coloradocube/balloonsat-bus/README.md

# ballonsat-bus
EPS, C&DH + COMMS or C3, CAN-FD for a balloonsat.

## Rework for v0.2

A list of [modification requirements](modifications.md).
