coloradocube/balloonsat-bus/EPS/Project Schedule_RevA.JPG

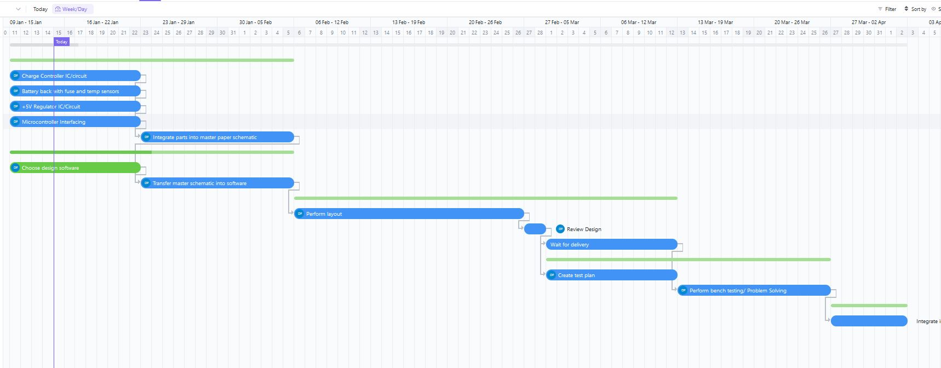
EPS/Project Schedule_RevA.JPG
