coloradocube/balloonsat-bus/Payload/Payload_level1.PNG

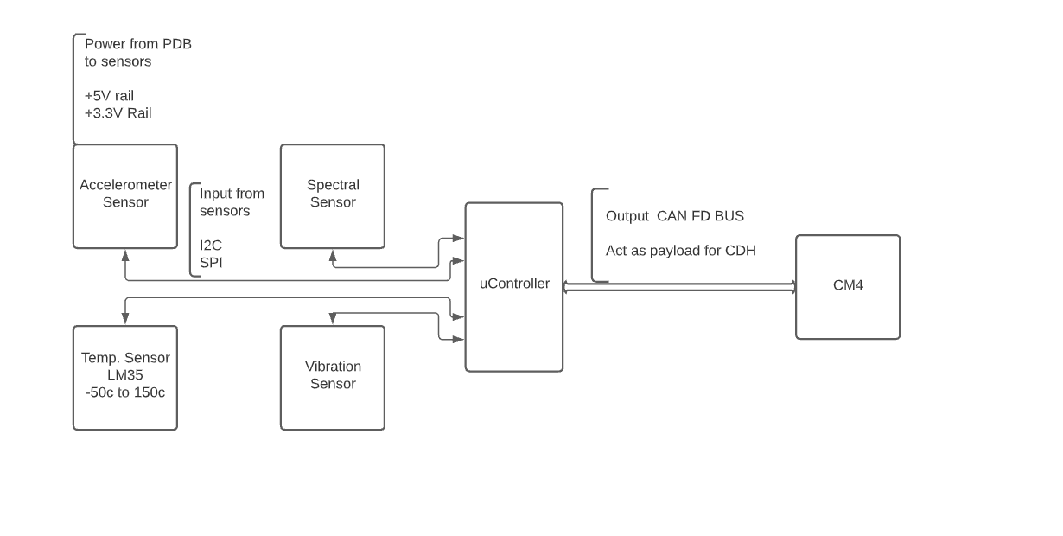
Payload/Payload_level1.PNG
