coloradocube/balloonsat-bus/Links.xlsx

For: | Description: | Link:
Power Board | Charge/Overcharge IC | https://www.addicore.com/TP4056-Charger-and-Protection-Module-p/ad310.htm
