coloradocube/balloonsat-bus/EPS/Misc Reference Docs/Budgets2.xls

Sheet: Main
Power Calculations for the RABBIT
Solar Constant | 1367 | W/m2 |  | Orbit | 800 | km
Efficiency | 15.0% |  |  | Period | 100.87 | min
Regulator Loss | 20.0% |  |  | Eclipse | 35.13 | min
switching Loss | 5.0% |  |  | Rev/day | 14.24
wiring Loss | 2.0% |  |  | REarth | 6378.14 | km
inherent degredation | 77.0%
packing factor | 80.0%
CubeSat length | 2.0
Area 1 | 0.002 | m2 | Minimum Area: 1/2 face open to environment
Area 2 | 0.016 | m2 | Side area for 1+ cube size
Area 3 | 0.008 | m2 | CubeSat side 8x10cm populated with cells
 |  |  | Power Avalable Whrs
Average Power Densities |  |  | per Orbit | per Day
Nominal | 1.06 | W | 1.16 | 16.50
Extended | 1.76 | W | 1.93 | 27.47

Sheet: Sun Angle
Sun Angle Approximation
Angle | Cosine | Adjusted
0 | 100.00% | 100.00%
5 | 99.62% | 99.62%
10 | 98.48% | 98.48%
15 | 96.59% | 96.58%
20 | 93.97% | 93.92%
25 | 90.63% | 90.46%
30 | 86.60% | 86.13%
35 | 81.92% | 80.85%
40 | 76.60% | 74.49%
45 | 70.71% | 66.96%
50 | 64.28% | 58.22%
55 | 57.36% | 48.29%
60 | 50.00% | 37.34%
65 | 42.26% | 25.64%
70 | 34.20% | 13.55%
75 | 25.88% | 1.52%
80 | 17.36% | 0.00%
85 | 8.72% | 0.00%
90 | 6.125742275e-15% | 0.00%

Sheet: Power Calcs
 | Percent Area visible in spin or tumble with respect to the sun |  |  |  |  |  | Power Provided during Spin or Tumble
 | Rotation about X |  |  | Rotation about X&Y |  |  | Nominal Cube |  | 1+ Cube
Angle | Area 1 | Area 2 | Area 3 | Area 1 | Area 2 | Area 3 | spin | tumble | spin | tumble
0 | 1.00 | 0.00 | 0.00 | 1.00 | 0.00 | 0.00 | 0.244 | 0.244 | 0.244 | 0.244
5 | 1.00 | 0.00 | 0.00 | 1.00 | 0.00 | 0.00 | 0.243 | 0.243 | 0.243 | 0.243
10 | 0.98 | 0.00 | 0.00 | 0.98 | 0.00 | 0.00 | 0.241 | 0.241 | 0.241 | 0.241
15 | 0.97 | 0.02 | 0.00 | 0.97 | 0.03 | 0.00 | 0.251 | 0.266 | 0.266 | 0.295
20 | 0.94 | 0.14 | 0.00 | 0.94 | 0.27 | 0.00 | 0.362 | 0.494 | 0.494 | 0.759
25 | 0.90 | 0.26 | 0.00 | 0.90 | 0.51 | 0.00 | 0.472 | 0.722 | 0.722 | 1.223
30 | 0.86 | 0.37 | 0.00 | 0.86 | 0.75 | 0.00 | 0.575 | 0.940 | 0.940 | 1.670
35 | 0.81 | 0.48 | 0.00 | 0.81 | 0.97 | 0.00 | 0.670 | 1.142 | 1.142 | 2.086
40 | 0.74 | 0.58 | 0.00 | 0.74 | 1.16 | 0.00 | 0.751 | 1.320 | 1.320 | 2.458
45 | 0.67 | 0.67 | 0.00 | 0.67 | 1.34 | 0.00 | 0.818 | 1.473 | 1.473 | 2.782
50 | 0.58 | 0.74 | 0.00 | 0.58 | 1.34 | 0.00 | 0.870 | 1.451 | 1.598 | 2.760
55 | 0.48 | 0.81 | 0.00 | 0.48 | 1.34 | 0.00 | 0.908 | 1.427 | 1.698 | 2.736
60 | 0.37 | 0.86 | 0.00 | 0.37 | 1.34 | 0.00 | 0.933 | 1.400 | 1.775 | 2.709
65 | 0.26 | 0.90 | 0.00 | 0.26 | 1.34 | 0.00 | 0.947 | 1.372 | 1.831 | 2.681
70 | 0.14 | 0.94 | 0.00 | 0.14 | 1.34 | 0.00 | 0.951 | 1.342 | 1.869 | 2.651
75 | 0.02 | 0.97 | 0.00 | 0.02 | 1.34 | 0.00 | 0.948 | 1.313 | 1.892 | 2.622
80 | 0.00 | 0.98 | 0.00 | 0.00 | 1.34 | 0.00 | 0.963 | 1.309 | 1.925 | 2.618
85 | 0.00 | 1.00 | 0.00 | 0.00 | 1.34 | 0.00 | 0.974 | 1.309 | 1.947 | 2.618
90 | 0.00 | 1.00 | 0.00 | 0.00 | 1.34 | 0.00 | 0.977 | 1.309 | 1.955 | 2.618
95 | 0.00 | 1.00 | 0.00 | 0.00 | 1.34 | 0.00 | 0.974 | 1.309 | 1.947 | 2.618
100 | 0.00 | 0.98 | 0.00 | 0.00 | 1.34 | 0.00 | 0.963 | 1.309 | 1.925 | 2.618
105 | 0.00 | 0.97 | 0.02 | 0.00 | 1.34 | 0.02 | 0.959 | 1.324 | 1.903 | 2.633
110 | 0.00 | 0.94 | 0.14 | 0.00 | 1.34 | 0.14 | 1.050 | 1.441 | 1.968 | 2.750
115 | 0.00 | 0.90 | 0.26 | 0.00 | 1.34 | 0.26 | 1.135 | 1.560 | 2.019 | 2.869
120 | 0.00 | 0.86 | 0.37 | 0.00 | 1.34 | 0.37 | 1.207 | 1.674 | 2.049 | 2.983
125 | 0.00 | 0.81 | 0.48 | 0.00 | 1.34 | 0.48 | 1.262 | 1.781 | 2.052 | 3.090
130 | 0.00 | 0.74 | 0.58 | 0.00 | 1.34 | 0.58 | 1.297 | 1.878 | 2.025 | 3.187
135 | 0.00 | 0.67 | 0.67 | 0.00 | 1.34 | 0.67 | 1.309 | 1.963 | 1.963 | 3.272
140 | 0.00 | 0.58 | 0.74 | 0.00 | 1.16 | 0.74 | 1.297 | 1.866 | 1.866 | 3.004
145 | 0.00 | 0.48 | 0.81 | 0.00 | 0.97 | 0.81 | 1.262 | 1.734 | 1.734 | 2.678
150 | 0.00 | 0.37 | 0.86 | 0.00 | 0.75 | 0.86 | 1.207 | 1.572 | 1.572 | 2.302
155 | 0.00 | 0.26 | 0.90 | 0.00 | 0.51 | 0.90 | 1.135 | 1.385 | 1.385 | 1.886
160 | 0.00 | 0.14 | 0.94 | 0.00 | 0.27 | 0.94 | 1.050 | 1.183 | 1.183 | 1.448
165 | 0.00 | 0.02 | 0.97 | 0.00 | 0.03 | 0.97 | 0.959 | 0.974 | 0.974 | 1.003
170 | 0.00 | 0.00 | 0.98 | 0.00 | 0.00 | 0.98 | 0.963 | 0.963 | 0.963 | 0.963
175 | 0.00 | 0.00 | 1.00 | 0.00 | 0.00 | 1.00 | 0.974 | 0.974 | 0.974 | 0.974
180 | 0.00 | 0.00 | 1.00 | 0.00 | 0.00 | 1.00 | 0.977 | 0.977 | 0.977 | 0.977
Average | 0.29 | 0.55 | 0.29 | 0.29 | 0.89 | 0.29 | 0.89 | 1.22 | 1.43 | 2.09

Sheet: Up-Link Margin
 | Up-Link Budget
 |  |  | El Angle | 0 | 10 | 35 | 65 | 90
Item | Symbol | Units | Source | DL | DL | DL | DL | DL
Antenna Efficiency | h | % | Input parameter | 55 | 55 | 55 | 55 | 55 | micro hard on narcissisat
Frequency | f | GHz | Input parameter | 2 | 2 | 2 | 2 | 2
Transmitter Power | P | Watts | Input parameter | 1 | 1 | 1 | 1 | 1
Transmitter Power | P | dBW | 10log(P) | 0 | 0 | 0 | 0 | 0
Transmitter Line Loss | Ll | dBW | Input parameter | -1 | -1 | -1 | -1 | -1
Transmit Antenna Beamwidth | qt | deg | Input parameter | 2 | 2 | 2 | 2 | 2
Peak Transmit Antenna Gain | Gpt | dB | Eq. (13-20) | 38.3 | 38.3 | 38.3 | 38.3 | 38.3
Transmit Antenna Diameter | Dt | m | Eq. (13-19) | 5.2 | 5.2 | 5.2 | 5.2 | 5.2
Transmit Antenna Pointing Offset | et | deg | Input parameter | 0.2 | 0.2 | 0.2 | 0.2 | 0.2
Transmit Antenna Pointing Loss | Lpt | dB | Eq. (13.21) | -0.12 | -0.12 | -0.12 | -0.12 | -0.12
Transmit Antenna Gain (net) | Gt | dB | Gpt+Lpt | 38.2 | 38.2 | 38.2 | 38.2 | 38.2
Eq. Isotropica Radiated Power | EIRP | dBW | P+Ll+Gt | 37.16 | 37.16 | 37.16 | 37.16 | 37.16
Propagation Path Length | S | km | from Main | 3293.18 | 2366.88 | 1263.90 | 872.25 | 800.00
Space Loss | Ls | dB | Eq (13-23a) | -168.8 | -166.0 | -160.5 | -157.3 | -156.5
Propagation and Polarization Loss | La | dB | Fig. 13-10 | -0.3 | -0.3 | -0.3 | -0.3 | -0.3
Recieve Antenna Diameter | Dr | m | Input parameter | 0.07 | 0.07 | 0.07 | 0.07 | 0.07
Peak Receive Antenna Gain (net) | Grp | dBi | Eq (13-18a) | 0.74 | 0.74 | 0.74 | 0.74 | 0.74
Recieve Antenna Beamwidth | qr | deg | Eq (13-19) | 150.0 | 150.0 | 150.0 | 150.0 | 150.0
Recieve Antenna Pointing Error | er | deg | Input parameter | 70 | 70 | 70 | 70 | 70
Receive Antenna Pointing Loss | Lpr | dB | Eq (13-21) | -2.6 | -2.6 | -2.6 | -2.6 | -2.6
Receive Antenna Gain | Gr | dB | Grp+Lpr | -1.9 | -1.9 | -1.9 | -1.9 | -1.9
System Noise Temperature | Ts | K | Table 13-10 | 614 | 614 | 614 | 614 | 614
Data Rate | R | bps | Input parameter | 100 | 100 | 100 | 100 | 100
Eb/No (1) | Eb/No | dB | Eq (13-13) | 44.4 | 47.3 | 52.7 | 55.9 | 56.7
Carrier-to-Noise Density Ratio | C/No | dB-Hz | Eq (13-15a) | 64.4 | 67.3 | 72.7 | 75.9 | 76.7
Bit Error Rate | BER |  | Input parameter | 1e-07 | 1e-07 | 1e-07 | 1e-07 | 1e-07
Required Eb/No (2) | Req Eb/No | dB-Hz | Fig. 13-9 | 11.3 | 11.3 | 11.3 | 11.3 | 11.3
Implimentation Loss (3) |  | dB | Estimated | -2 | -2 | -2 | -2 | -2
Margin |  | dB | (1)-(2)+(3) | 31.1 | 34.0 | 39.4 | 42.6 | 43.4

Sheet: Down-Link Margin
 | Down-Link Budget
 |  |  | El Angle | 0 | 10 | 35 | 65 | 90
Item | Symbol | Units | Source | DL | DL | DL | DL | DL
Antenna Efficiency | h | % | Input parameter | 25 | 25 | 25 | 25 | 25
Frequency | f | GHz | Input parameter | 2.4 | 2.4 | 2.4 | 2.4 | 2.4
Transmitter Power | P | Watts | Input parameter | 1 | 1 | 1 | 1 | 1
Transmitter Power | P | dBW | 10log(P) | 0 | 0 | 0 | 0 | 0
Transmitter Line Loss | Ll | dBW | Input parameter | -0.25 | -0.25 | -0.25 | -0.25 | -0.25
Transmit Antenna Beamwidth | qt | deg | Input parameter | 70 | 70 | 70 | 70 | 70
Peak Transmit Antenna Gain | Gpt | dB | Eq. (13-20) | 0.0 | 0.0 | 0.0 | 0.0 | 0.0
Transmit Antenna Diameter | Dt | m | Eq. (13-19) | 0.1 | 0.1 | 0.1 | 0.1 | 0.1
Transmit Antenna Pointing Offset | et | deg | Input parameter | 27 | 27 | 27 | 27 | 27
Transmit Antenna Pointing Loss | Lpt | dB | Eq. (13.21) | 0.0 | 0.0 | 0.0 | 0.0 | 0.0
Transmit Antenna Gain (net) | Gt | dB | Gpt+Lpt | 0.0 | 0.0 | 0.0 | 0.0 | 0.0
Eq. Isotropica Radiated Power | EIRP | dBW | P+Ll+Gt | -0.25 | -0.25 | -0.25 | -0.25 | -0.25
Propagation Path Length | S | km | from Main | 3293.18 | 2366.88 | 1263.90 | 872.25 | 800.00
Space Loss | Ls | dB | Eq (13-23a) | -170.4 | -167.5 | -162.1 | -158.9 | -158.1
Propagation and Polarization Loss | La | dB | Fig. 13-10 | -0.3 | -0.3 | -0.3 | -0.3 | -0.3
Recieve Antenna Diameter | Dr | m | Input parameter | 20.0 | 20 | 20 | 20 | 20
Peak Receive Antenna Gain (net) | Grp | dBi | Eq (13-18a) | 48.01 | 48.01 | 48.01 | 48.01 | 48.01
Recieve Antenna Beamwidth | qr | deg | Eq (13-19) | 0.4 | 0.4 | 0.4 | 0.4 | 0.4
Recieve Antenna Pointing Error | er | deg | Input parameter | 0.2 | 0.2 | 0.2 | 0.2 | 0.2
Receive Antenna Pointing Loss | Lpr | dB | Eq (13-21) | -2.5 | -2.5 | -2.5 | -2.5 | -2.5
Receive Antenna Gain | Gr | dB | Grp+Lpr | 45.5 | 45.5 | 45.5 | 45.5 | 45.5
System Noise Temperature | Ts | K | Table 13-10 | 135 | 135 | 135 | 135 | 135
Data Rate | R | bps | Input parameter | 1200 | 1200 | 1200 | 1200 | 110000
Eb/No (1) | Eb/No | dB | Eq (13-13) | 48.5 | 51.4 | 56.9 | 60.1 | 41.2
Carrier-to-Noise Density Ratio | C/No | dB-Hz | Eq (13-15a) | 79.3 | 82.2 | 87.7 | 90.9 | 91.6
Bit Error Rate | BER |  | Input parameter | 1e-06 | 1e-06 | 1e-06 | 1e-06 | 1e-06
Required Eb/No (2) | Req Eb/No | dB-Hz | Fig. 13-9 | 14 | 14 | 14 | 14 | 14
Implimentation Loss (3) |  | dB | Estimated | -2 | -2 | -2 | -2 | -2
Margin |  | dB | (1)-(2)+(3) | 32.5 | 35.4 | 40.9 | 44.1 | 25.2

Sheet: Comm Budget
Reading | 8 | bit |  |  |  | reading | 8 | bit
Time | 1 | per min |  |  |  | Time | 1 | per hour
Temp Sensors |  | Voltages |  | Current |  | MRC |  | FFPG
panels | 6 | bus | 1 | panels | 6 | data | 1000 | data | 1000
battery | 1 | battery | 1 | battery | 1
structure | 5 | convertors | 3 | bus | 1
cpu | 1 |  |  | convertors | 3
TX | 2 |  |  | cpu | 1
EPS | 3 |  |  | TX | 1
 |  |  |  | payload | 8
bps | 2.4 |  | 0.6666666667 |  | 2.8 |  | 2.222222222 |  | 2.222222222
Total | 10.31111111 | bps
 | 890880 | bp day
growth factor | 2
passes | 4 | 8 | 4 | 4 | 8 | 4
total time | 32 | min
rate | 928 | baud

Sheet: Power Budget
Always on |  | @ 5min/hr |  | Transmit
Payload 1 Standby | 0.25 | MRC | 2 | TX | 1
Payload 2 Standby | 0.5 | FFPG | 3
CPU | 0.5
RX | 0.25
AX.25 controller | 0.5
Totals | 2 |  | 5 |  | 1
WattHrs | 2 |  | 0.25 |  | 0.02222222222
Total WHr | 2.272222222
Per Day | 54.53333333
