coloradocube/balloonsat-bus/EPS/Battery Board/Battery Board/Battery Board.csv

Source: | C:\Users\alecj\Documents\GitHub\balloonsat-bus\EPS\Battery Board\Battery Board\Battery Board.kicad_sch
Date: | 3/24/2022 9:11:50 PM
Tool: | Eeschema (6.0.1)
Generator: | C:\Program Files\KiCad\6.0\bin\scripting\plugins/bom_csv_grouped_by_value_with_fp.py
Component Count: | 9
Ref | Qnty | Value | Cmp name | Footprint | Description | Vendor
F1, F2, F3, F4, | 4 | 65800001009 | 65800001009 | Fuse holder:65800001009
J1, | 1 | 436500212 | 436500212 | Connecter:436500212
U1, U2, U3, U4, | 4 | 1042 | 1042 | Battery holder:1042
