coloradocube/balloonsat-bus/Payload/ColoradoCUBE_Payloads/MS580502BA01-50/3D/MS580502BA01-50.stp

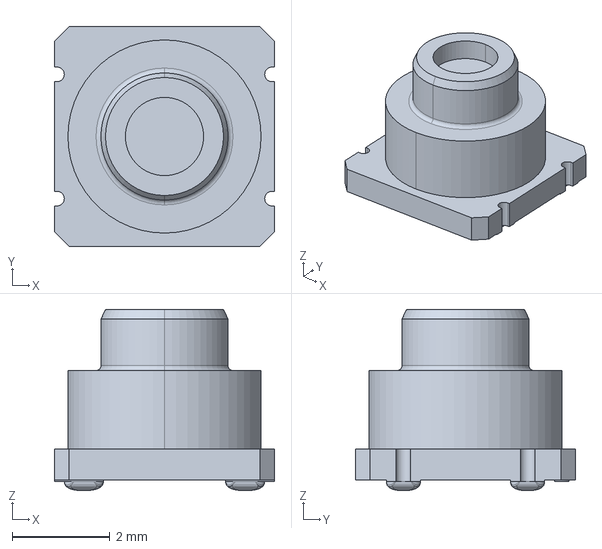
[picture p11: CAD file, 2022-04-02]
Payload/ColoradoCUBE_Payloads/MS580502BA01-50/3D/MS580502BA01-50.stp
4.50 x 4.50 x 3.71 mm
