coloradocube/balloonsat-bus/(list of files, cad)

Other CAD files:
Payload/ColoradoCUBE_Payloads/MS580502BA01-50/Allegro/ms580502ba0150.psm
Payload/ColoradoCUBE_Payloads/MS580502BA01-50/DEHDL/ms580502ba01_50/chips/chips.prt
