coloradocube/balloonsat-bus/(threads)

Thread 4 (2021-11-17):

C&DG board design

ivogeorg, 2021-11-17:

NotfatPrince, 2021-11-17:
# To Do
Study current [CM4 IO](https://datasheets.raspberrypi.com/cm4io/cm4io-datasheet.pdf) board and decide what we want to keep and what we need to add.

Thread 7 (2022-01-12):

EPS Paper schematic

dperry29, 2022-01-12:
Seth- Charge port & charge controller IC/circuit
Dan T- Battery back with fuse and temp sensors
Alec - DC/DC regulator IC/circuit
Dan P - Microcontroller interface with PDB and kria

Closed 2022-02-02.

Thread 8 (2022-01-12):

EPS PCB software schematic

dperry29, 2022-01-12:
Transition paper schematic into PCB software (Eagle or Kicad? TBD)

dperry29, 2022-02-02:
Working on integrating individual parts into master kicad sch
