coloradocube/balloonsat-bus/COMMS/Comms_TopLevel_v1.pdf

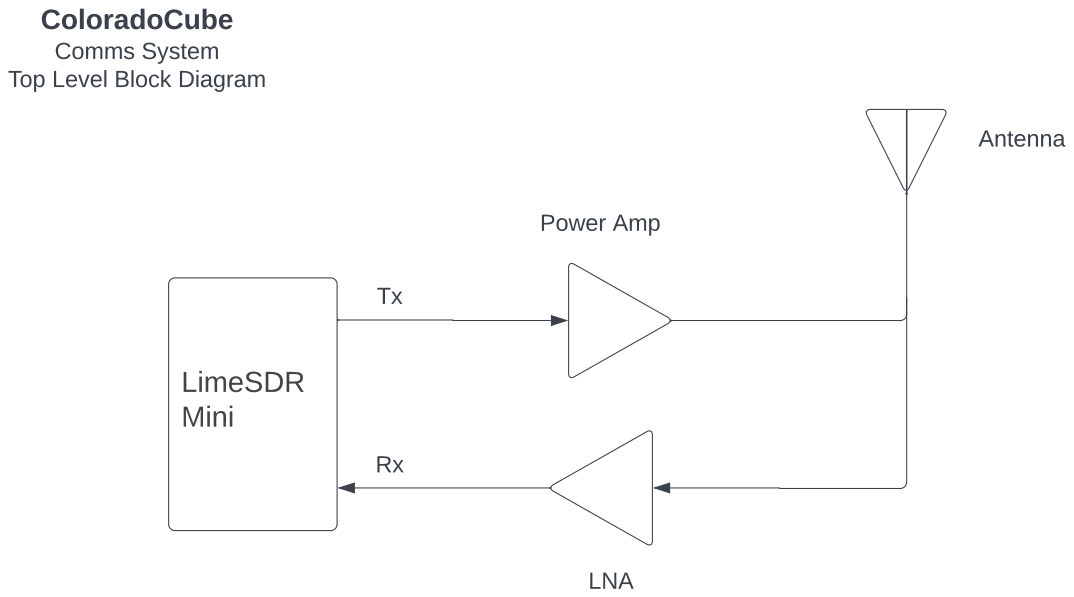
[picture p12: page 1]
LimeSDR Mini; Antenna; Power Amp; LNA

ColoradoCube
Comms System
Top Level Block Diagram
