coloradocube/balloonsat-bus/CD&H/C&DH.pdf

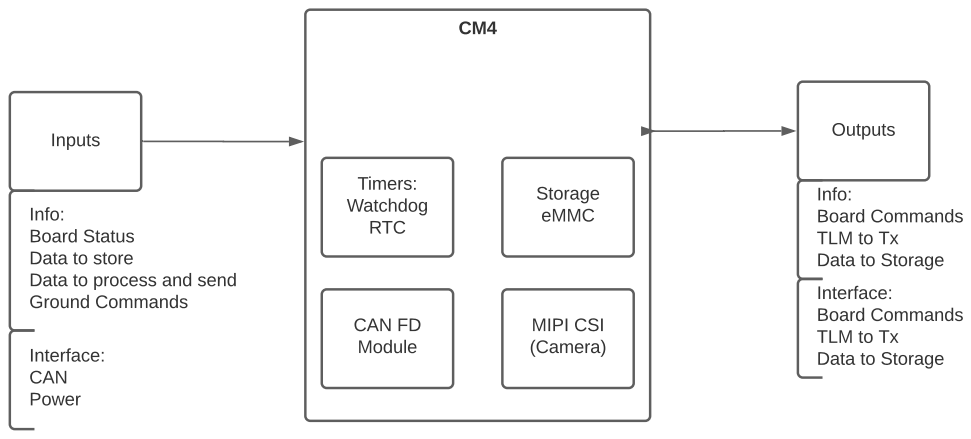
[picture p13: page 1]
s Info: Board Status Data to store Data to process and send Ground Commands Interface: CAN Power; Info: Board Co; ule; s: Watchdo g; MIPI C

Tim
SI (Camera) Storage eMMC

e Interface: Board Comman
