coloradocube/balloonsat-bus/CD&H/C&DH_level1.pdf

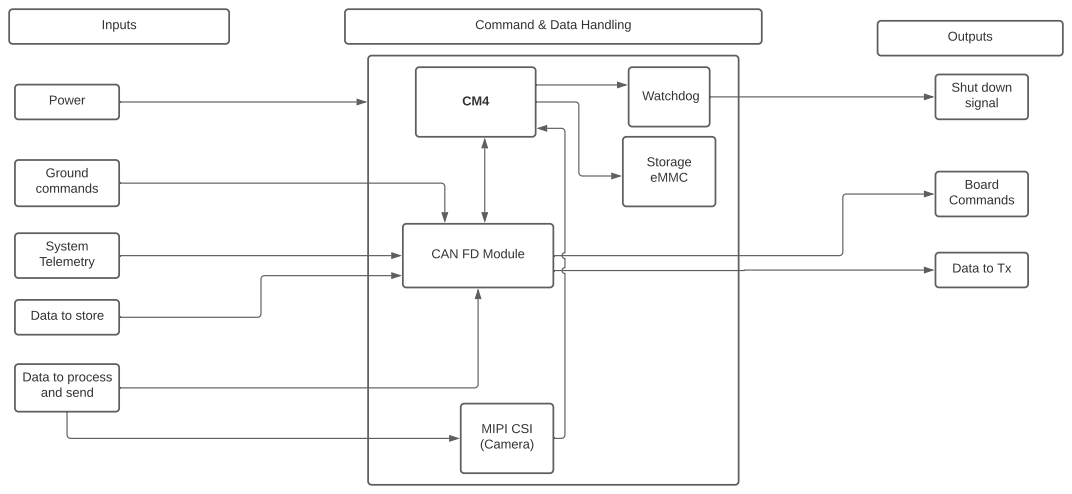
[picture p14: page 1]
ule; MIPI C; SI (Camera); dlin; Tele; sig
