coloradocube/balloonsat-bus/COMMS/COMMS_level1.pdf

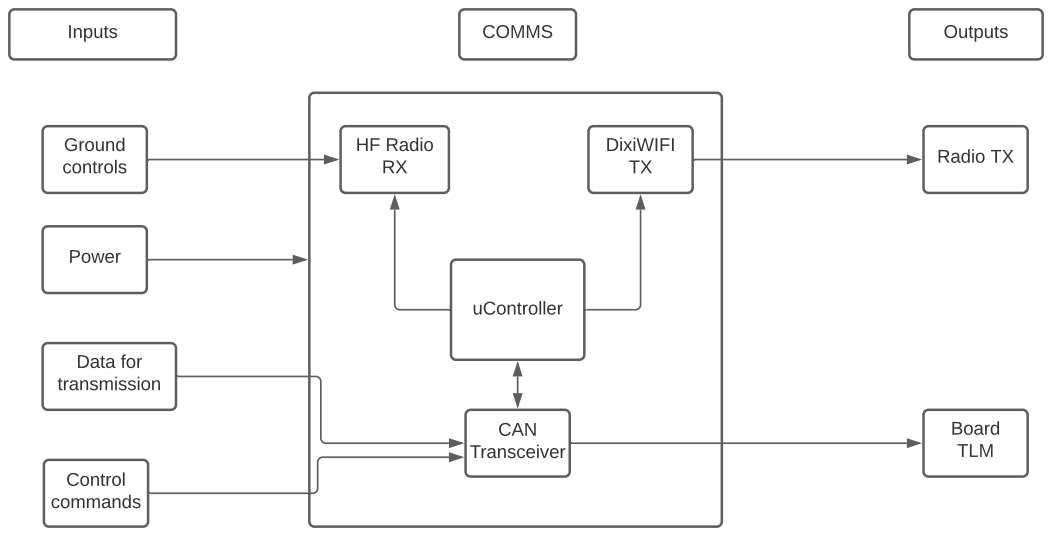
[picture p15: page 1]
Text; Inputs; COMMS; Outputs; HF Radio RX; uController; DixiWIFI TX; Data for transmission; Ground controls; Power; Control commands; Board TLM; Radio TX; CAN Transceiver
