coloradocube/balloonsat-bus/EPS/Block Diagrams/PDB_BlockDiagram_Rev-B.pdf

# ail +5V Rail +3.3V Rail XX Max C

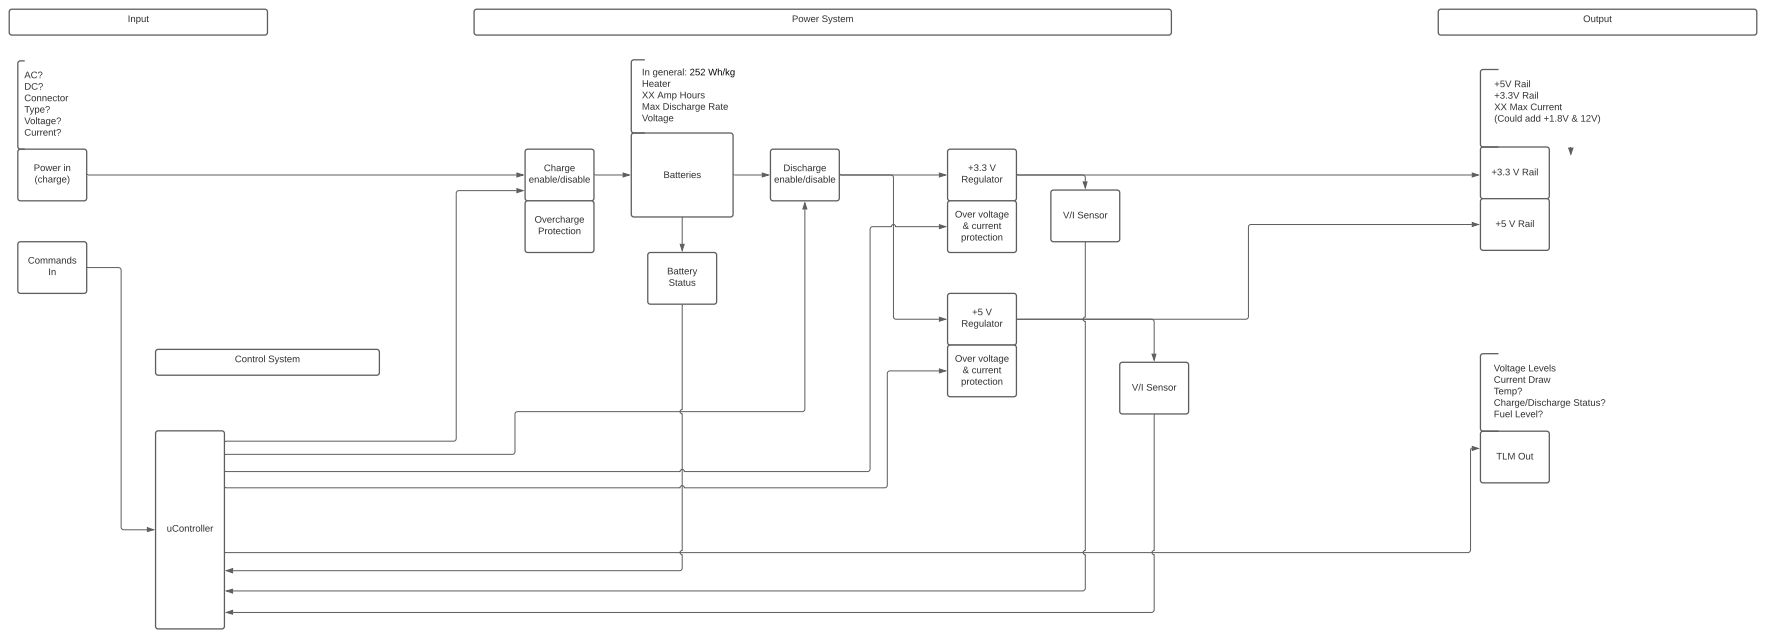
[picture p17: page 1]
s Input; Dis; ble; dis; uld; Volt; els; olle; rie; s In general: 252; ula; olt; tio; ail Charge
