coloradocube/balloonsat-bus/EPS/Block Diagrams/PDB_BlockDiagram_Rev-A.pdf

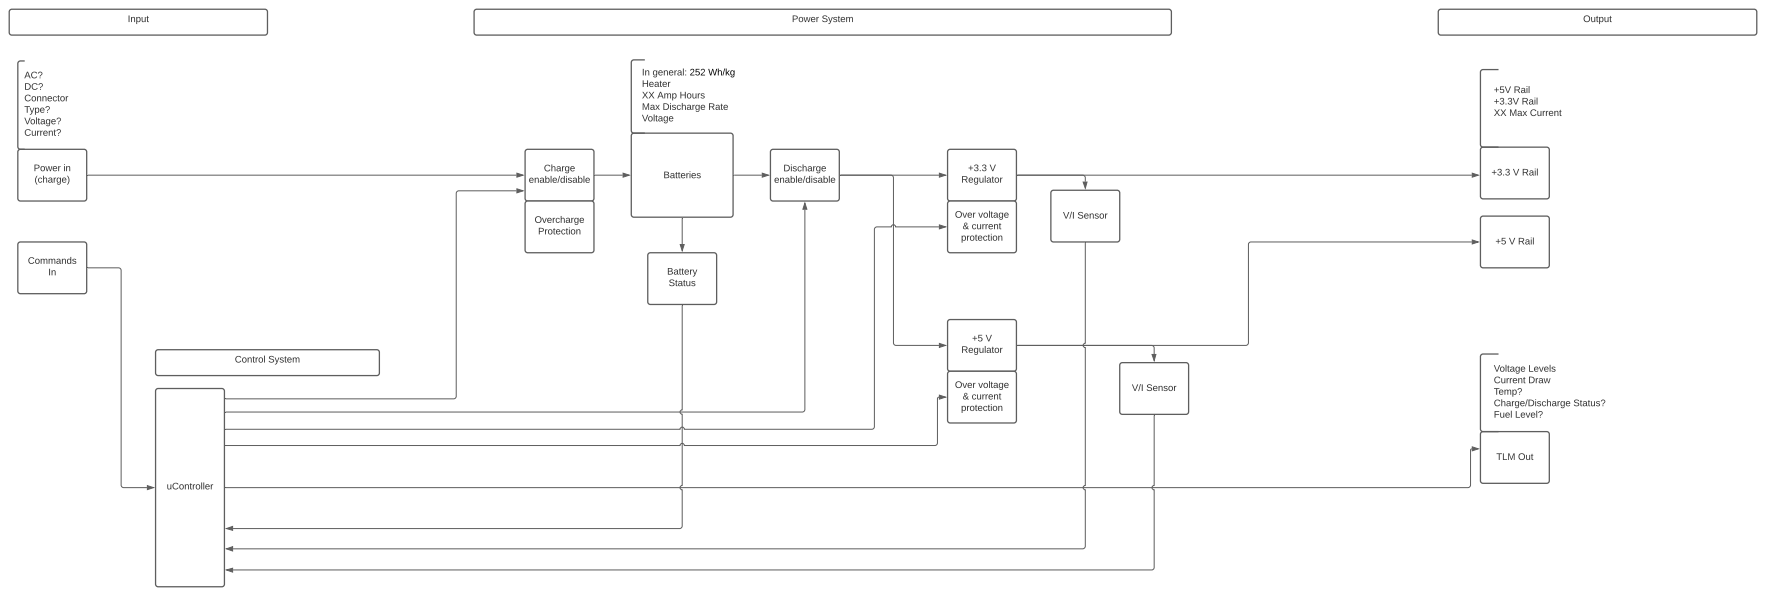
[picture p18: page 1]
s Input; Dis; ble; dis; Volt; els; olle; rie; s In general: 252; ula; olt; tio; ail Charge

ail +5V Rail +3.3V Rail XX Max Cu
