coloradocube/balloonsat-bus/(commit log)

2021-12-13 Reorganizing PDB
    Changed from PDB (power distro board) to EPS (electrical power subsytem. Added reference docs folder
2021-12-13 Added ref docs
    [Budgets2.xls, Power rev2.xls, Power.xls]
2022-01-15 Updated File Structure
    Updated File Structure
    [Budgets2.xls, EPS Master Schedule.xlsx, Power rev2.xls, Power.xls]
2022-01-24 Adding kicad folder
    [CDH.csv, CDH.kicad_pcb, CDH.kicad_sch, CM4IOv5.kicad_pcb, CM4IOv5.kicad_sch, CM4_GPIO.kicad_sch, CM4_HighSpeed.kicad_sch, PCIe.kicad_sch]
2022-01-26 added kicad libraries
2022-02-01 first upload
    [charge schem.kicad_pcb, charge schem.kicad_sch]
2022-02-01 added one piece - test
    [charge schem.kicad_sch]
2022-02-04 master schematic
    uploading the main schematic with all designs
    [charge schem.kicad_sch, converterschematic.kicad_sch, master_schematic.kicad_pcb, master_schematic.kicad_sch]
2022-02-11 Added MCU/CAN to master schematic
    [MCU_CAN.kicad_sch, master_schematic.kicad_sch]
2022-02-14 master schematic update
    added hierarchal pins to MCU_CAN, and attached it with the rest of the circuit
    [MCU_CAN.kicad_sch, master_schematic.kicad_sch]
2022-02-18 Updatig kiCAD files for C&DH
    [CDH.csv, CDH.kicad_pcb, CDH.kicad_sch, CM4IOv5.kicad_pcb, CM4IOv5.kicad_sch, CM4_GPIO.kicad_sch, CM4_HighSpeed.kicad_sch, PCIe.kicad_sch]
2022-02-19 added general CAD schematic for Danny
2022-02-25 updated master Schematic
    updated MCU
2022-02-25 actual master schematic update
    added mcu other files
    [CAN_Transceiver.kicad_sch, ColoradoCUBE_Payload.kicad_sch, DEBUG_INTERFACE.kicad_sch, Interboard_connector.kicad_sch, converterschematic.kicad_sch, eps_board.kicad_pcb, master_schematic.kicad_sch, pcb_template.kicad_pcb]
2022-02-25 revised EPS schematics
    [ColoradoCUBE_Payload.kicad_sch, Interboard_connector.kicad_sch, charge schem.kicad_sch, converterschematic.kicad_sch, master_schematic.kicad_sch, pcb_template.kicad_pcb]
2022-03-02 master schematic/pcb update
    updates schematic with OVP and added OVP to the PCB layout
    [Interboard_connector.kicad_sch, OVP.kicad_sch, eps_board.kicad_pcb, master_schematic.kicad_sch]
2022-03-02 updated master schematic
    should be nearing final schematic revision. run electrical rules check next
    [CAN_Transceiver.kicad_sch, ColoradoCUBE_Payload.kicad_sch, DEBUG_INTERFACE.kicad_sch, Interboard_connector.kicad_sch, OVP.kicad_sch, charge schem.kicad_sch, converterschematic.kicad_sch, master_schematic.csv]
2022-03-03 EPS master netlist complete
    dropped all parts onto pcb
    [CAN_Transceiver.kicad_sch, ColoradoCUBE_Payload.kicad_sch, OVP.kicad_sch, charge schem.kicad_sch, converterschematic.kicad_sch, master_schematic.kicad_pcb, master_schematic.kicad_sch]
2022-03-04 pcb update
    progress on pcb layout
    [OVP.kicad_sch, master_schematic.kicad_pcb, master_schematic.kicad_sch]
2022-03-05 updated pcb layout
    last thing needed is the charger schematic
    [OVP.kicad_sch, converterschematic.kicad_sch, master_schematic.kicad_pcb, master_schematic.kicad_sch]
2022-03-05 updated pcb layout
    last thing that needs to be implemented is the charge circuit
2022-03-10 EPS board updated
    [charge schem.kicad_sch, converterschematic.kicad_sch, master_schematic.kicad_pcb, master_schematic.kicad_sch]
2022-03-12 eps updated
    [charge schem.kicad_sch, master_schematic.kicad_pcb]
2022-03-17 all traces routed (EPS)
    all nets, traces, etc connected.....now we need to run DRC...errors are inevitable
    [ColoradoCUBE_Payload.kicad_sch, charge schem.kicad_sch, master_schematic.kicad_pcb, master_schematic.kicad_sch]
2022-03-17 [EPS] updated *some* DRC rules...
    there are a lot
    [master_schematic.kicad_pcb]
2022-03-18 Battery board added
    [Battery Board.csv, Battery Board.kicad_pcb, Battery Board.kicad_sch]
2022-03-18 [EPS] updated DRC errors
    fixed/updated rules to have no errors. however the dimensions might not work with manufacturers.... also, silkscreens need to be moved/resized
    [charge schem.kicad_sch, master_schematic.kicad_pcb]
2022-03-20 eps pcb update
    all errors and warnings corrected
    [OVP.kicad_sch, master_schematic.kicad_pcb, master_schematic.kicad_sch]
2022-04-01 Eps board update
    vias fixed for manufacturers standards, eliminated ALRT pin on battery gauge
    [ColoradoCUBE_Payload.kicad_sch, charge schem.kicad_sch, converterschematic.kicad_sch, master_schematic.kicad_pcb, master_schematic.kicad_sch]
2022-04-02 added link to change uart ports on cm4
2022-04-02 Added current notes on configuring UART ports on Rpi
2022-04-02 ColoradoCUBE_Payloads
    same as ColoradoCUBE_Payload_Update.zip
    [CAN_Transceiver.kicad_sch, CAN_Ttransceiver.kicad_sch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]
2022-04-19 eps redesign
    updated boost converter
    [converterschematic.kicad_sch, master_schematic.kicad_pcb, master_schematic.kicad_sch]
2022-04-19 eps redesign
    last update did not go through
    [Battery Board.csv]
2022-04-21 PCB rework images
2022-04-21 EPS 2.0 update
    added alert pins to microcontroller
    [ColoradoCUBE_Payload.kicad_sch, converterschematic.kicad_sch, master_schematic.kicad_pcb, master_schematic.kicad_sch]
2022-04-21 modifications for v2
    CDH: UART connector relocation, LED relocation, removed EEPROM solder jumper
    Payload: Removed connection to GND of unconnected ground-plane pins, adjusted traces
    [CDH.kicad_pcb, CDH.kicad_sch, ColoradoCUBE_Payload.kicad_pcb, Interboard_connector.kicad_sch, cm4-high-speed.kicad_sch]
